lukeMiP/Beat-Box/v4/MEDIA/Untitled Project (7).jpg

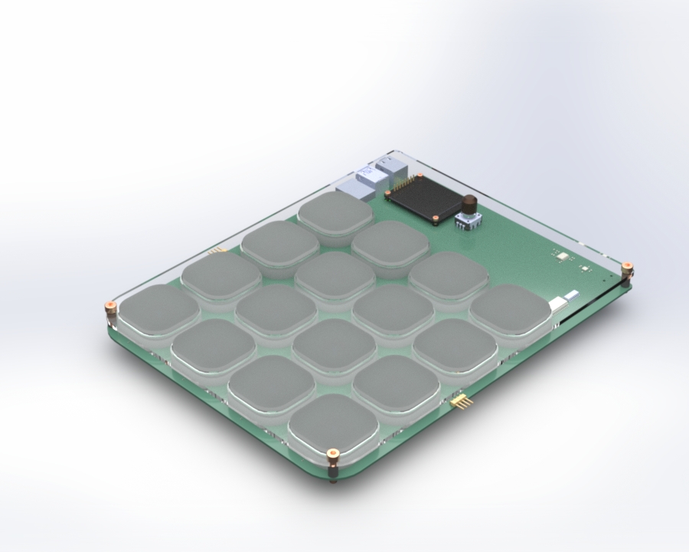
v4/MEDIA/Untitled Project (7).jpg
