lukeMiP/Beat-Box/v4/MEDIA/layout image.png

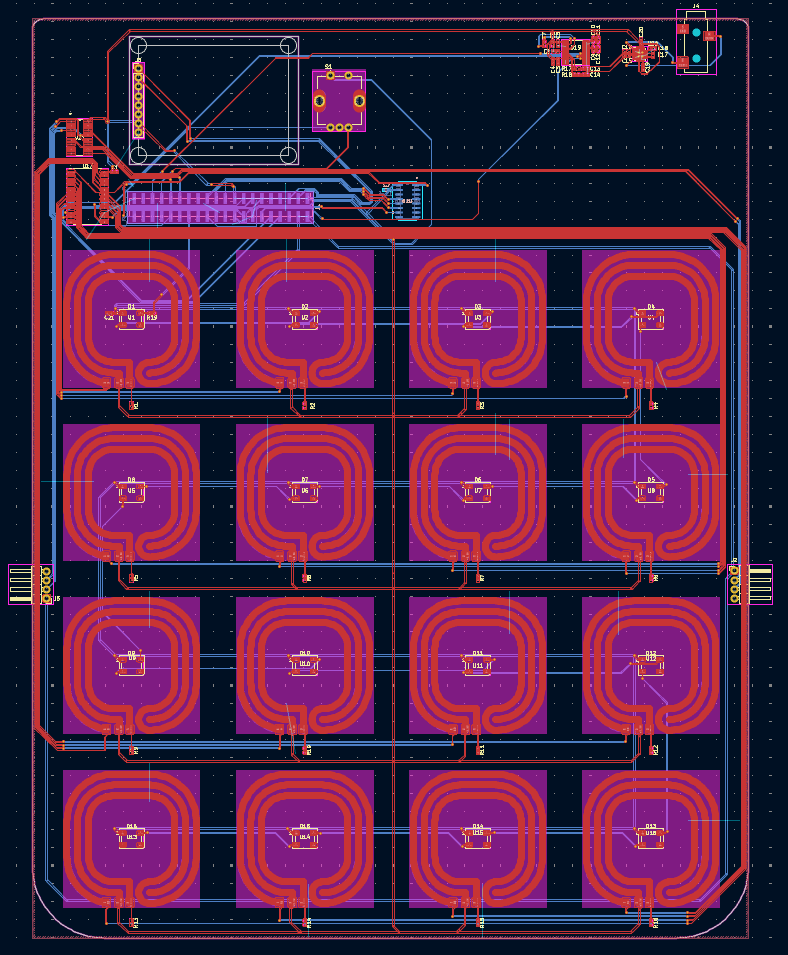
v4/MEDIA/layout image.png
