lukeMiP/Beat-Box/v3/SOLIDWORKS/V3.SLDASM

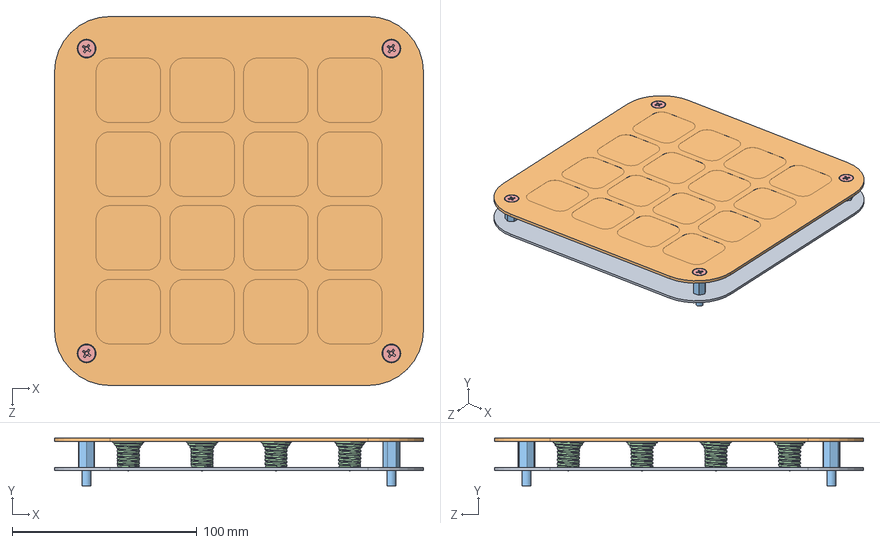
[picture p3: CAD file, 2025-08-02, an earlier design]
v3/SOLIDWORKS/V3.SLDASM
200.0 x 26.0 x 200.0 mm
PCB
Top
Standoffs x 4
CapacitiveTouchSpring x 16
cross countersunk head screw_as x 4
