lukeMiP/Beat-Box/v1/SOLIDWORKS/Full Assem v1.SLDASM

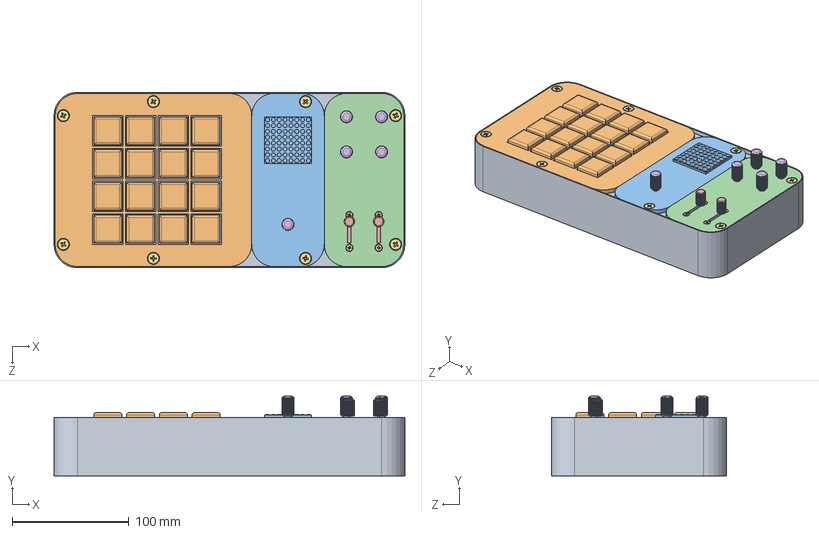
[picture p4: CAD file, 2025-08-02, an earlier design]
v1/SOLIDWORKS/Full Assem v1.SLDASM
300.0 x 68.0 x 150.0 mm
Base
KeyPad
Visulize
Switch Plate
Slide x 2
Knob x 5
cross countersunk head screw_as x 12
