lukeMiP/Beat-Box/v2/SOLIDWORKS/Full Assem v2.SLDASM

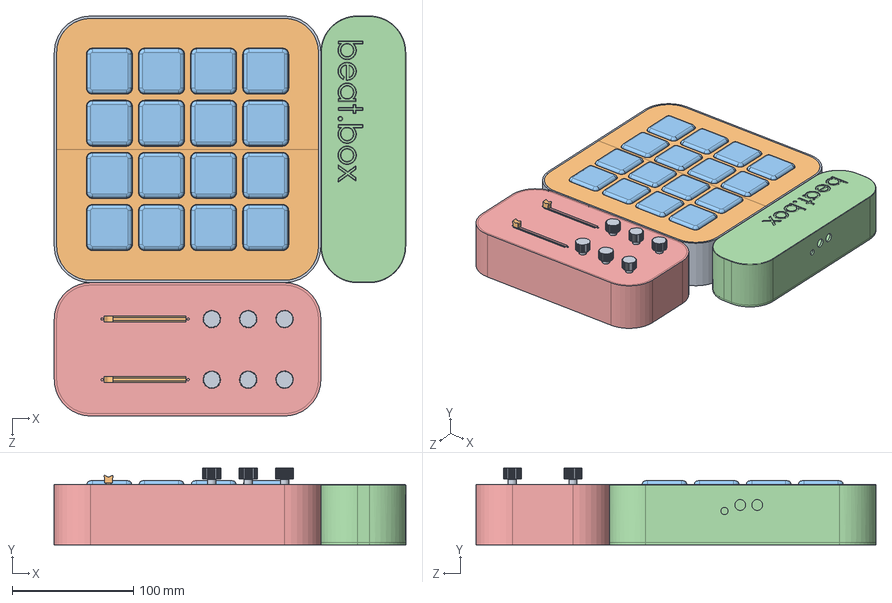
[picture p5: CAD file, 2025-08-02, an earlier design]
v2/SOLIDWORKS/Full Assem v2.SLDASM
290.0 x 63.5 x 330.0 mm
Drum Top Plate
SoundPlayer
PotPad
cross countersunk head screw_as x 4
MagPlug x 2
MagSocket x 2
Pot x 6
SlidePot x 2
