lukeMiP/Beat-Box/v1/SOLIDWORKS/Base.SLDPRT

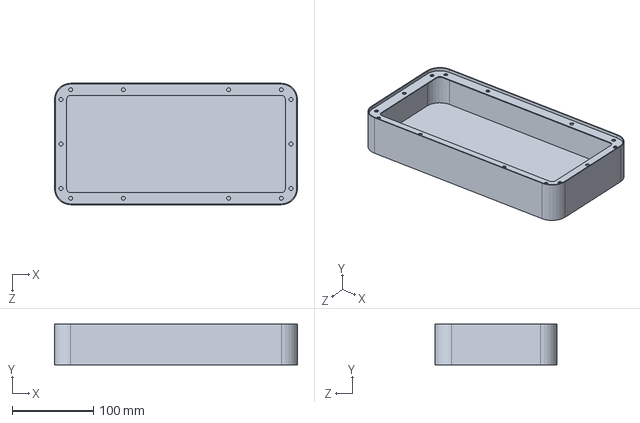
[picture p6: CAD file, 2025-08-02, an earlier design]
v1/SOLIDWORKS/Base.SLDPRT
300.0 x 50.0 x 150.0 mm
