lukeMiP/Beat-Box/v2/SOLIDWORKS/MagPlug.SLDPRT

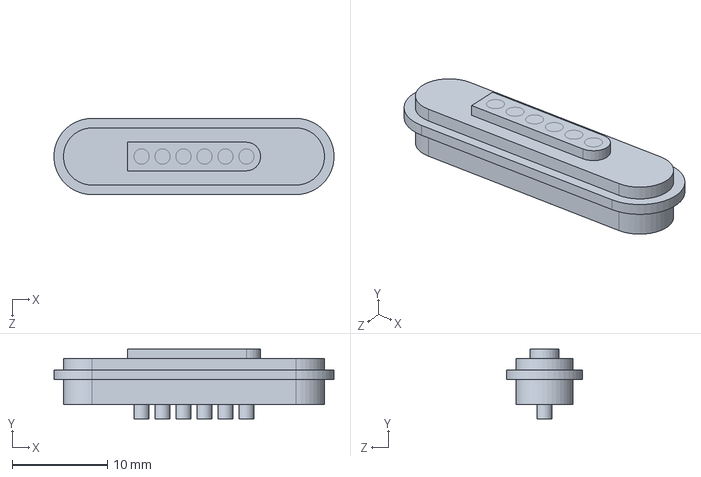
[picture p7: CAD file, 2025-08-02, an earlier design]
v2/SOLIDWORKS/MagPlug.SLDPRT
29.4 x 7.30 x 8.00 mm
