lukeMiP/Beat-Box/v3/SOLIDWORKS/Standoffs.SLDPRT

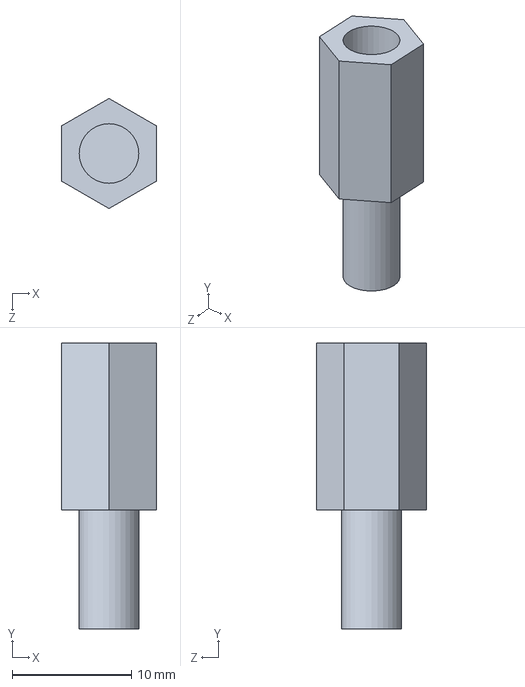
[picture p8: CAD file, 2025-08-02, an earlier design]
v3/SOLIDWORKS/Standoffs.SLDPRT
8.00 x 24.0 x 9.24 mm
