lukeMiP/Beat-Box/v1/SOLIDWORKS/KeyPad.SLDPRT

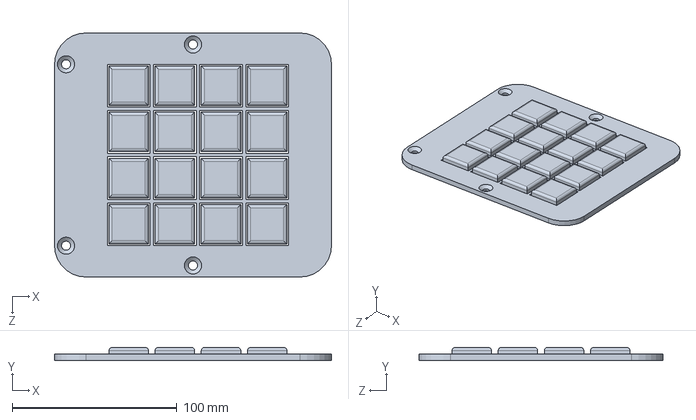
[picture p9: CAD file, 2025-08-02, an earlier design]
v1/SOLIDWORKS/KeyPad.SLDPRT
168.0 x 8.00 x 148.0 mm
