lukeMiP/Beat-Box/v2/SOLIDWORKS/TopOpen.SLDPRT

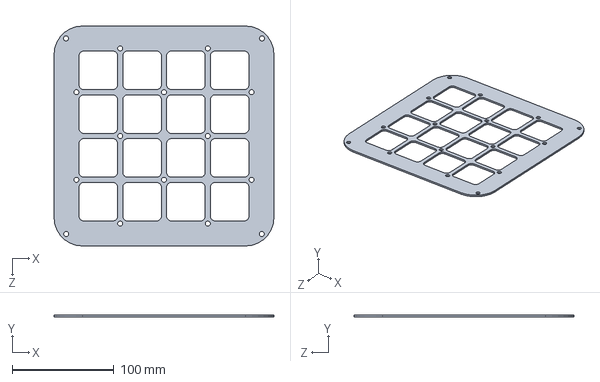
[picture p10: CAD file, 2025-08-02, an earlier design]
v2/SOLIDWORKS/TopOpen.SLDPRT
216.0 x 2.00 x 216.0 mm
