lukeMiP/Beat-Box/v3/SOLIDWORKS/CapacitiveTouchSpring.SLDPRT

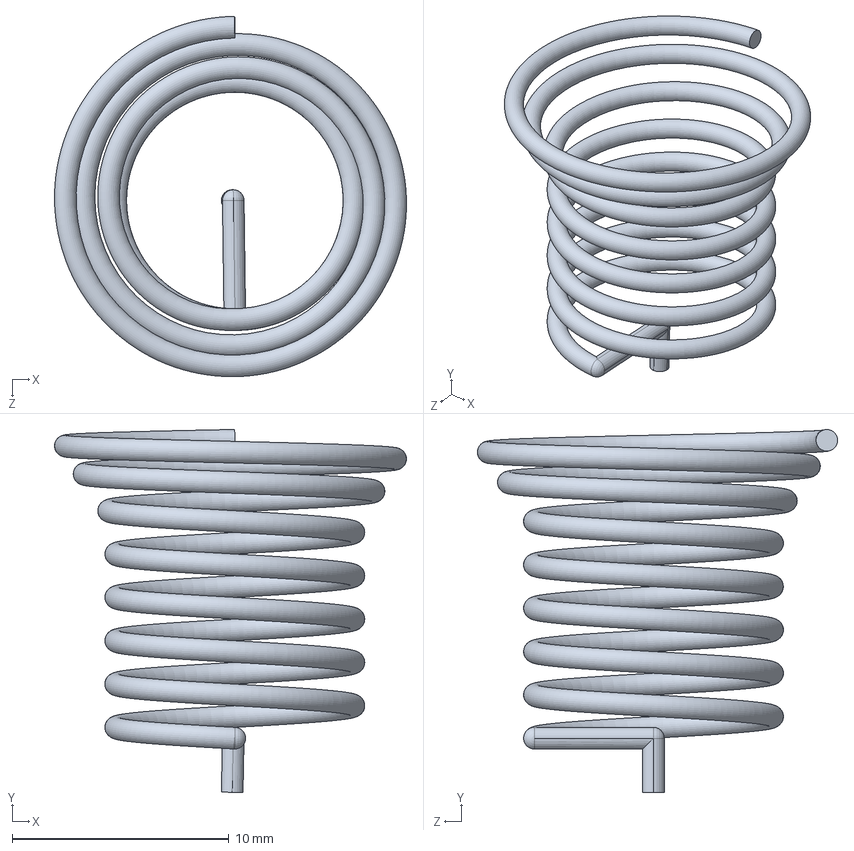
[picture p11: CAD file, 2025-08-02, an earlier design]
v3/SOLIDWORKS/CapacitiveTouchSpring.SLDPRT
16.2 x 16.8 x 16.6 mm
