lukeMiP/Beat-Box/v1/SOLIDWORKS/Switch Plate.SLDPRT

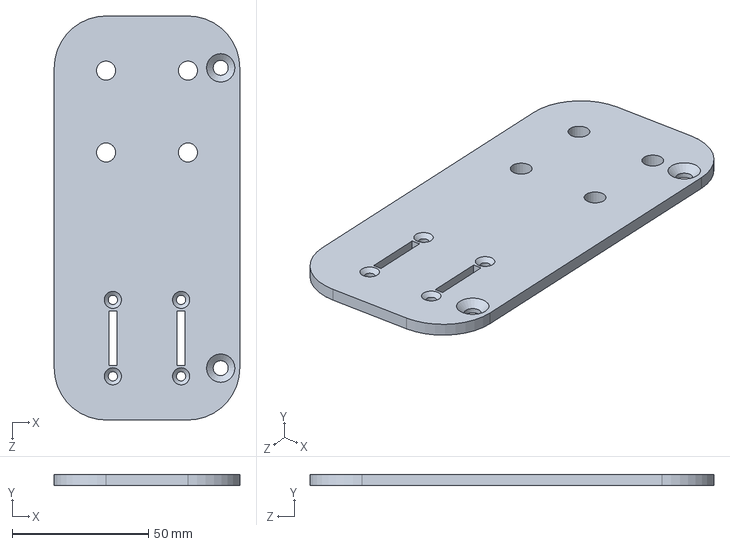
[picture p12: CAD file, 2025-08-02, an earlier design]
v1/SOLIDWORKS/Switch Plate.SLDPRT
68.0 x 4.00 x 148.0 mm
