lukeMiP/Beat-Box/v2/SOLIDWORKS/Drum Top Plate.SLDPRT

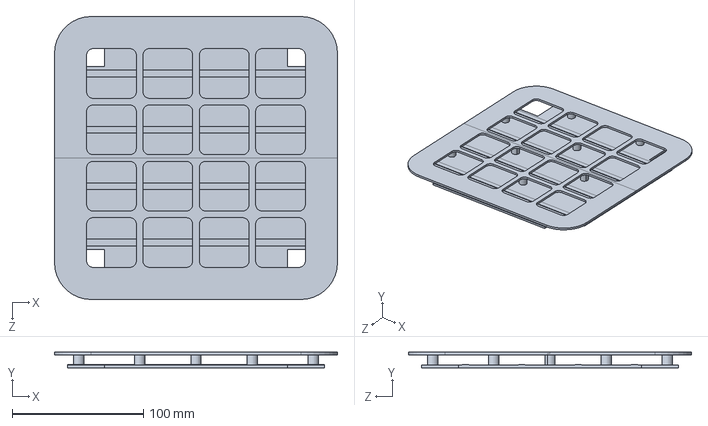
[picture p13: CAD file, 2025-08-02, an earlier design]
v2/SOLIDWORKS/Drum Top Plate.SLDPRT
216.0 x 12.0 x 216.0 mm
