lukeMiP/Beat-Box/v2/SOLIDWORKS/Drum Base.SLDPRT

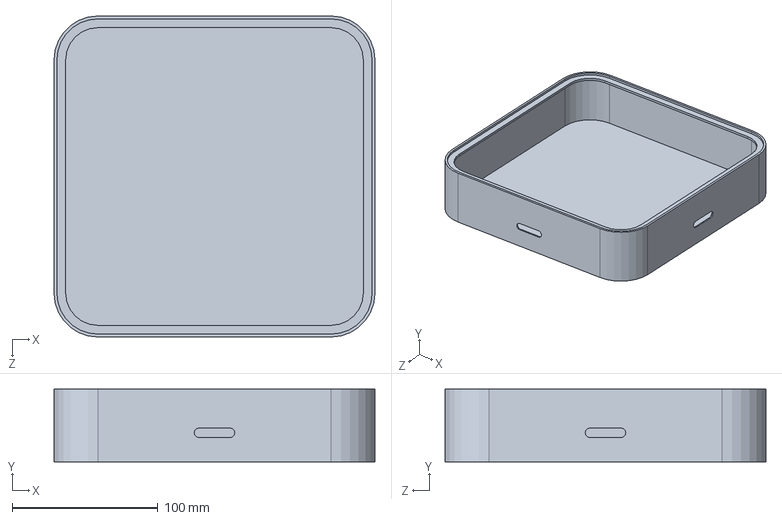
[picture p14: CAD file, 2025-08-02, an earlier design]
v2/SOLIDWORKS/Drum Base.SLDPRT
220.0 x 50.0 x 220.0 mm
