lukeMiP/Beat-Box/v3/SOLIDWORKS/Top.SLDPRT

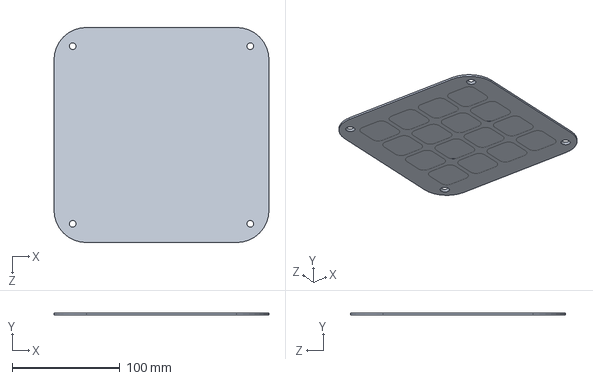
[picture p15: CAD file, 2025-08-02, an earlier design]
v3/SOLIDWORKS/Top.SLDPRT
200.0 x 2.00 x 200.0 mm
