lukeMiP/Beat-Box/v1/SOLIDWORKS/Knob.SLDPRT

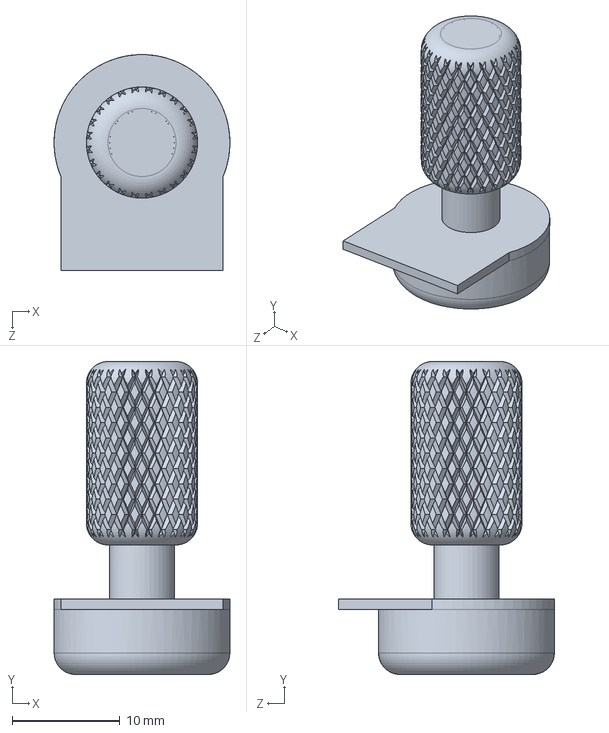
[picture p16: CAD file, 2025-08-02, an earlier design]
v1/SOLIDWORKS/Knob.SLDPRT
16.3 x 29.0 x 20.0 mm
