lukeMiP/Beat-Box/v2/SOLIDWORKS/Button.SLDPRT

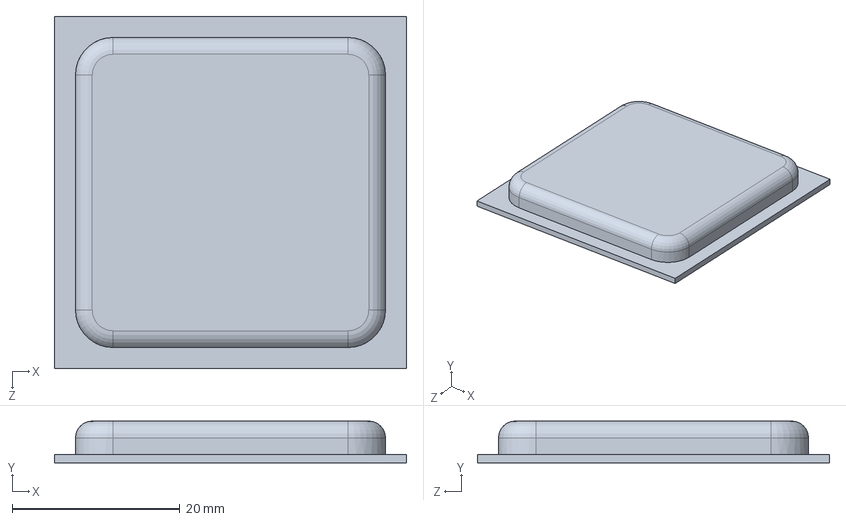
[picture p17: CAD file, 2025-08-02, an earlier design]
v2/SOLIDWORKS/Button.SLDPRT
42.0 x 5.00 x 42.0 mm
