lukeMiP/Beat-Box/v3/SOLIDWORKS/PCB.SLDPRT

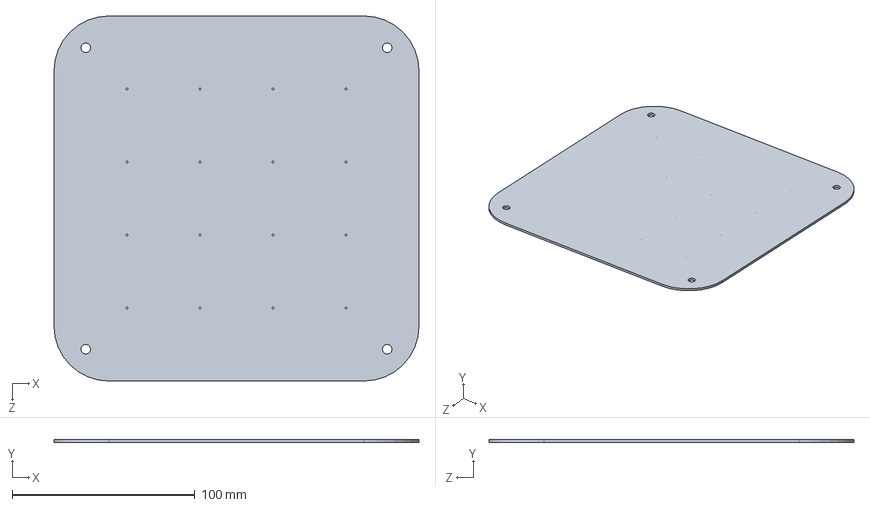
[picture p18: CAD file, 2025-08-02, an earlier design]
v3/SOLIDWORKS/PCB.SLDPRT
200.0 x 1.60 x 200.0 mm
