lukeMiP/Beat-Box/v1/SOLIDWORKS/Visulize.SLDPRT

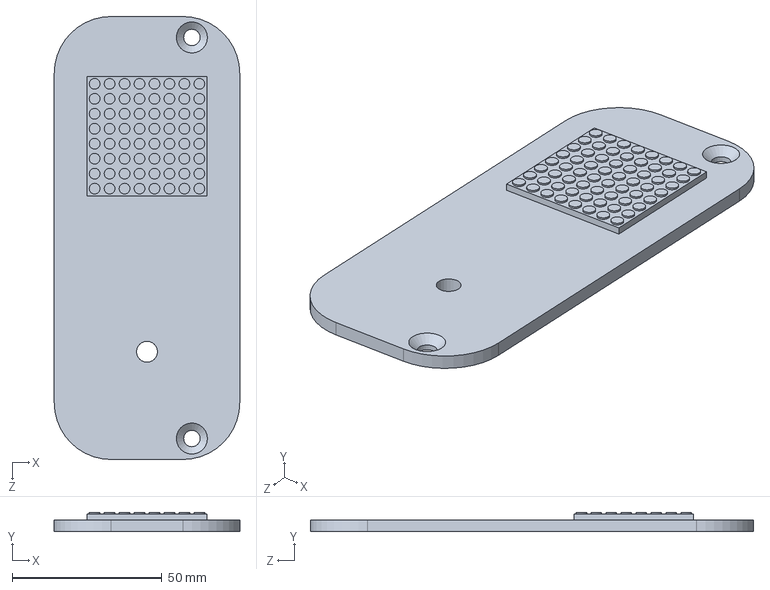
[picture p19: CAD file, 2025-08-02, an earlier design]
v1/SOLIDWORKS/Visulize.SLDPRT
62.0 x 6.50 x 148.0 mm
