lukeMiP/Beat-Box/v2/SOLIDWORKS/StandoffOpen.SLDPRT

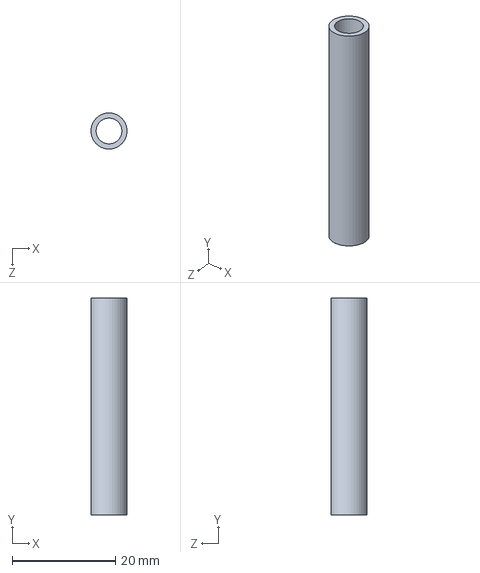
[picture p20: CAD file, 2025-08-02, an earlier design]
v2/SOLIDWORKS/StandoffOpen.SLDPRT
6.98 x 42.0 x 7.00 mm
