lukeMiP/Beat-Box/(list of files, cad)

Other CAD files:
v1/SOLIDWORKS/Slide.SLDPRT
v2/SOLIDWORKS/BottomOpen.SLDPRT
v2/SOLIDWORKS/MagHolderOpen.SLDPRT
v2/SOLIDWORKS/MagSocket.SLDPRT
v2/SOLIDWORKS/Pad.SLDPRT
v2/SOLIDWORKS/Pot.SLDPRT
v2/SOLIDWORKS/PotPad.SLDPRT
v2/SOLIDWORKS/SlidePot.SLDPRT
v2/SOLIDWORKS/SoundPlayer.SLDPRT
