lukeMiP/Beat-Box/v2/EASYEDA/Schematic_DrumV2_2025-08-02.pdf

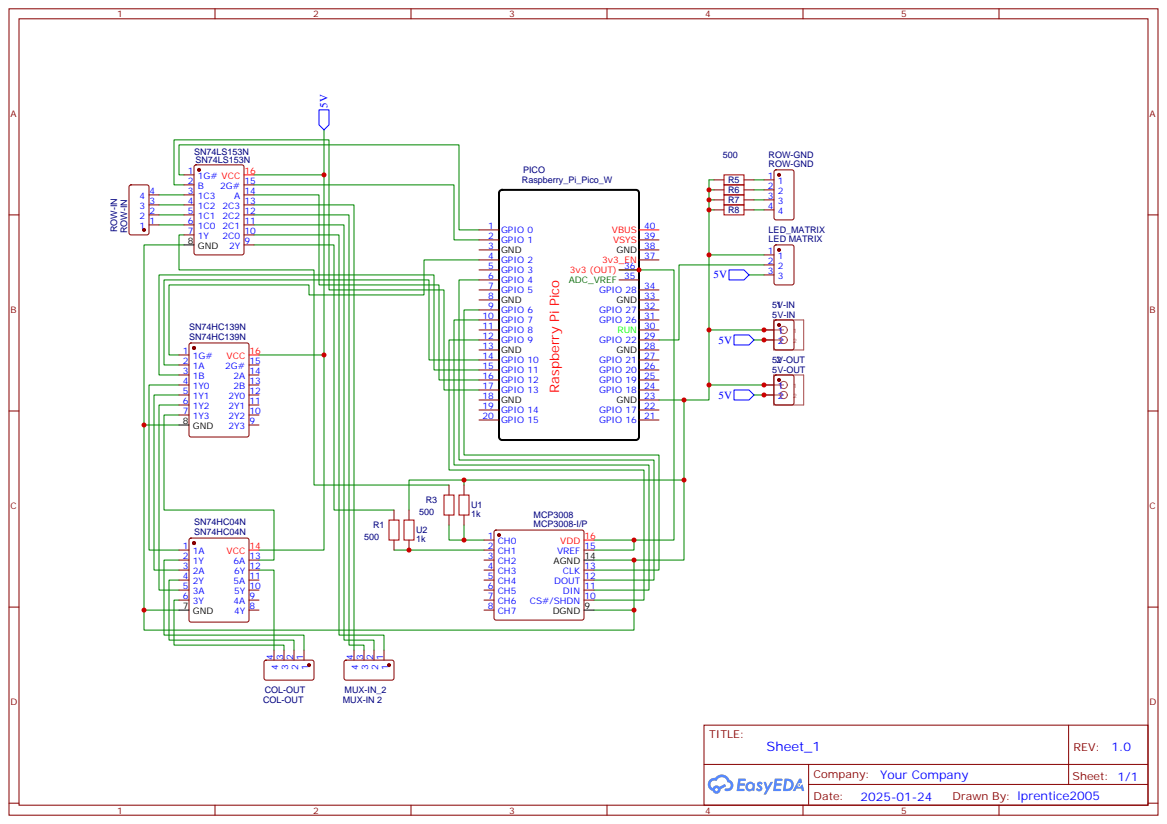
[picture p21: page 1]

MCP3008
MCP3008-I/P
CS#/SHDN 10 DIN 11 DOUT 12 CLK 13 AGND 14 VREF 15 VDD 16
