lukeMiP/Beat-Box/v2/EASYEDA/PCB_PCB_DrumV2_2025-08-02.pdf

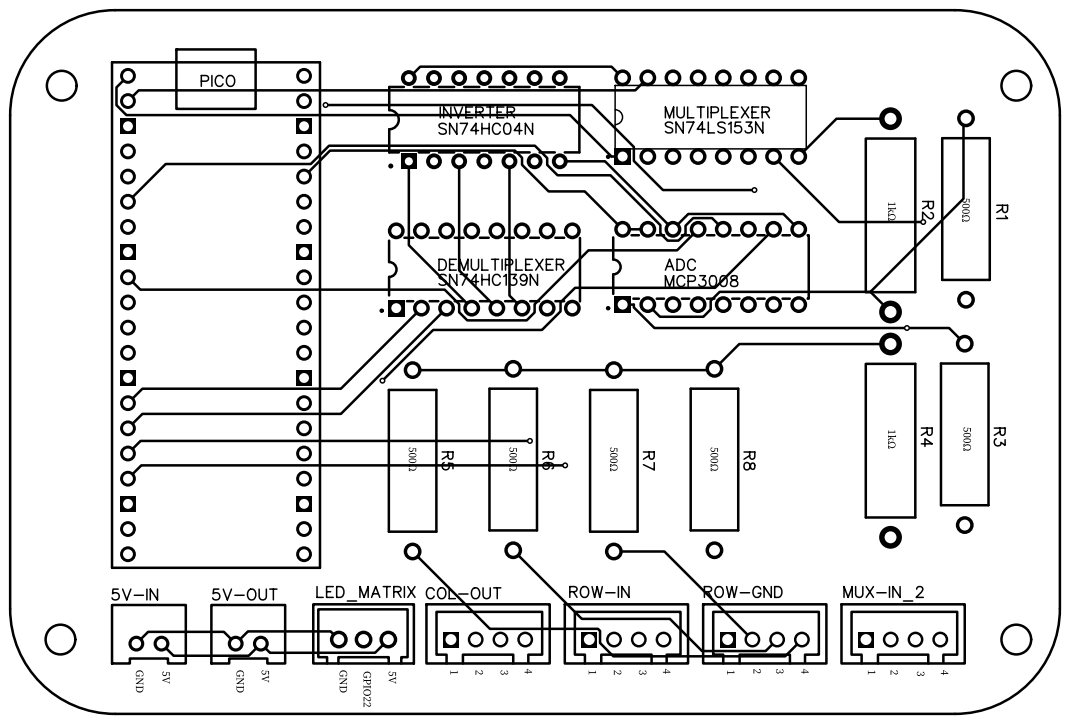
[picture p22: page 1]
