lukeMiP/Beat-Box/v2/SOLIDWORKS/DrumV2.pdf

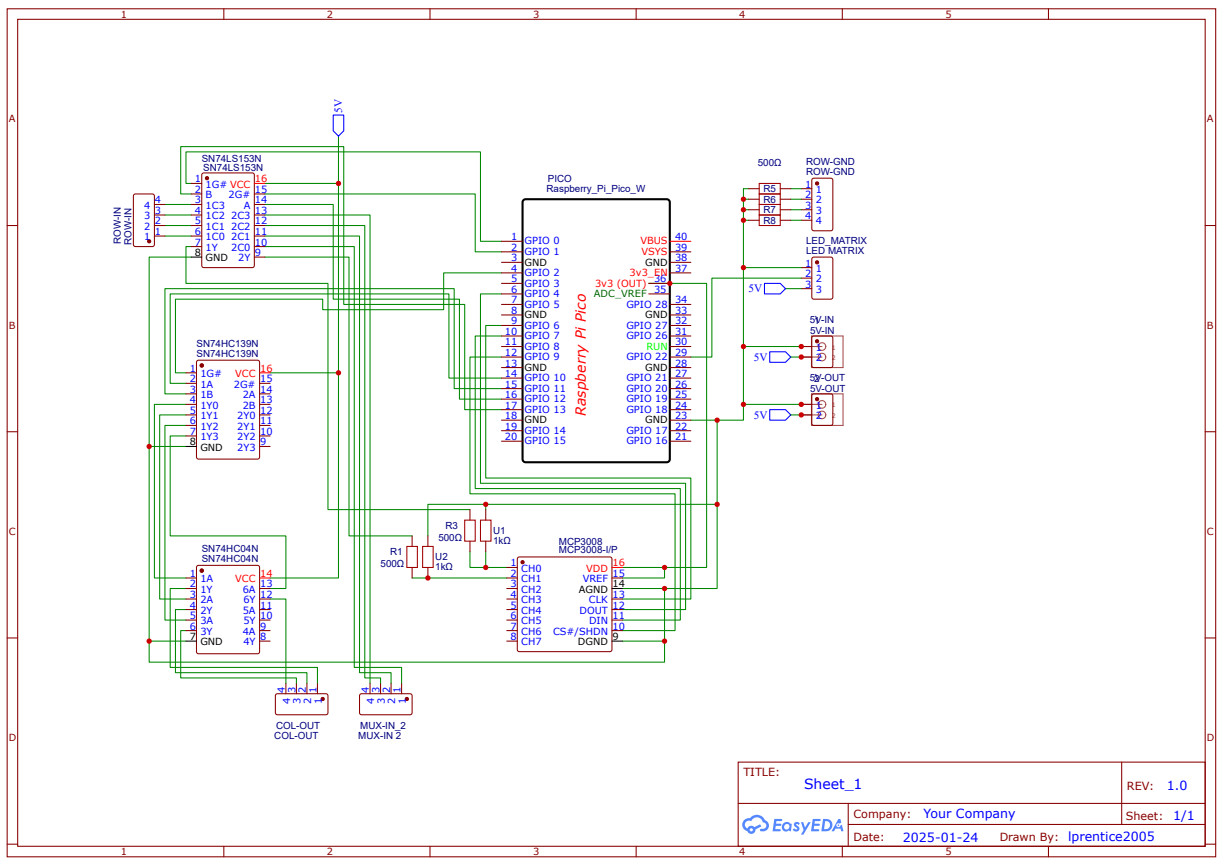
[picture p23: page 1]
