lukeMiP/Beat-Box/v4/FINAL VERSION/KiCad/final version.kicad_pcb

## KiCad design v4/FINAL VERSION/KiCad/final version.kicad_pcb (2025-08-17)

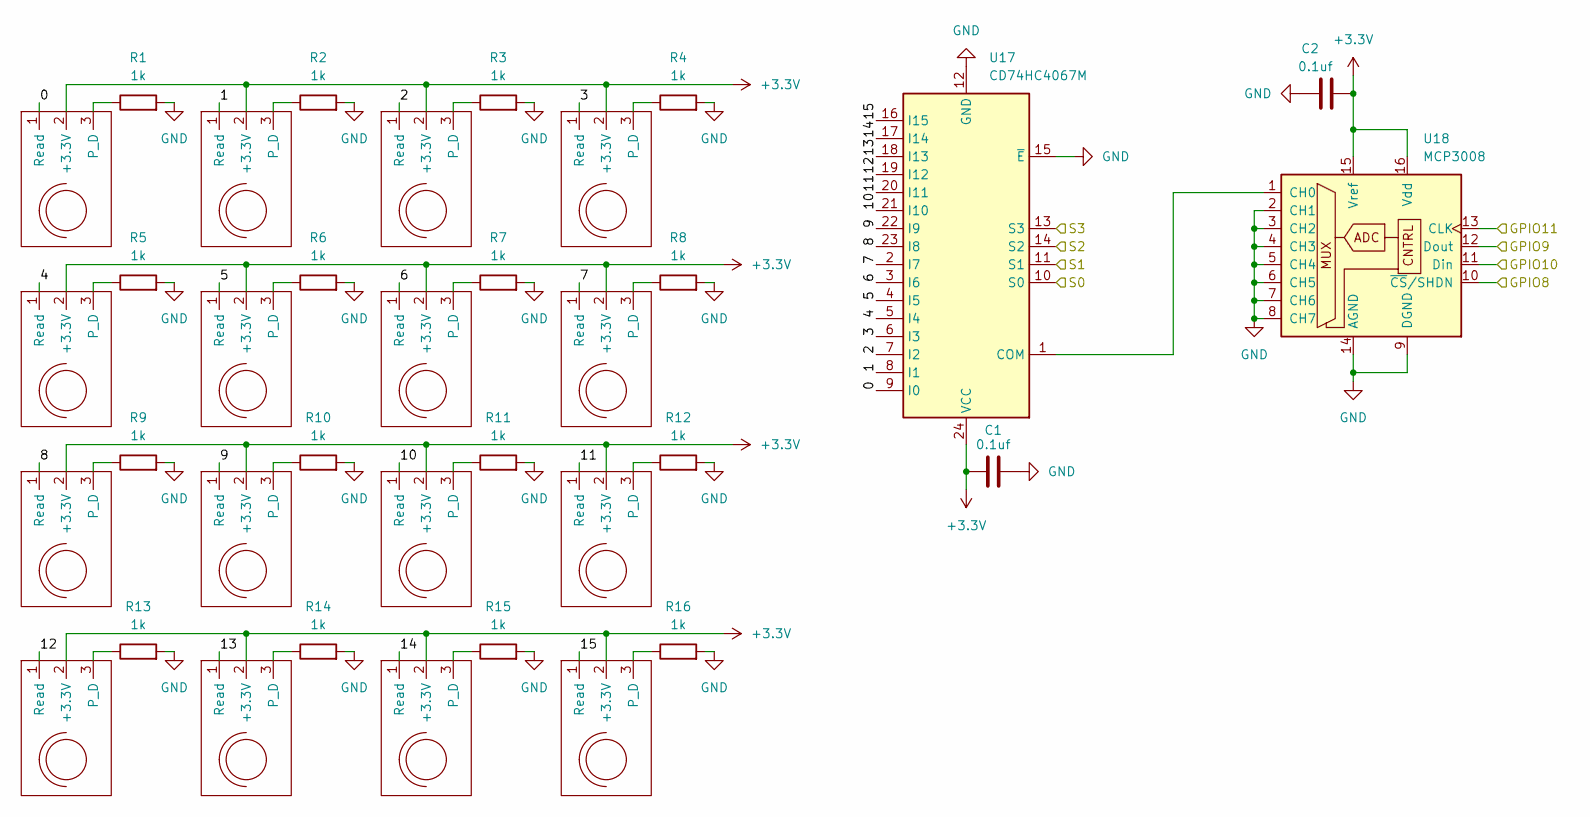
[picture p24: schematic MATRIX.kicad_sch]

Parts:
C1, C2: 0.1uf; C_0805_2012Metric_Pad1.18x1.45mm_HandSolder
R1, R2, R3, R4, R5, R6, R7, R8, R9, R10, R11, R12, R13, R14, R15, R16: 1k; R_0805_2012Metric_Pad1.20x1.40mm_HandSolder
U1, U2, U3, U4, U5, U6, U7, U8, U9, U10, U11, U12, U13, U14, U15, U16: VeloPad
U17: CD74HC4067M; SOIC-24W_7.5x15.4mm_P1.27mm
U18: MCP3008; SOIC16-N_MC_MCH-M

Connections:
+3.3V: C1.1, C2.1, U1.2 (+3.3V), U2.2 (+3.3V), U3.2 (+3.3V), U4.2 (+3.3V), U5.2 (+3.3V), U6.2 (+3.3V), U7.2 (+3.3V), U8.2 (+3.3V), U9.2 (+3.3V), U10.2 (+3.3V), U11.2 (+3.3V), U12.2 (+3.3V), U13.2 (+3.3V), U14.2 (+3.3V), U15.2 (+3.3V), U16.2 (+3.3V), U17.24 (VCC), U18.15 (Vref), U18.16 (Vdd); also elsewhere on the board
/MATRIX/0: U1.1 (Read), U17.9 (I0)
/MATRIX/1: U2.1 (Read), U17.8 (I1)
/MATRIX/2: U3.1 (Read), U17.7 (I2)
/MATRIX/3: U4.1 (Read), U17.6 (I3)
/MATRIX/4: U5.1 (Read), U17.5 (I4)
/MATRIX/5: U6.1 (Read), U17.4 (I5)
/MATRIX/6: U7.1 (Read), U17.3 (I6)
/MATRIX/7: U8.1 (Read), U17.2 (I7)
/MATRIX/8: U9.1 (Read), U17.23 (I8)
/MATRIX/9: U10.1 (Read), U17.22 (I9)
/MATRIX/10: U11.1 (Read), U17.21 (I10)
/MATRIX/11: U12.1 (Read), U17.20 (I11)
/MATRIX/12: U13.1 (Read), U17.19 (I12)
/MATRIX/13: U14.1 (Read), U17.18 (I13)
/MATRIX/14: U15.1 (Read), U17.17 (I14)
/MATRIX/15: U16.1 (Read), U17.16 (I15)
/MATRIX/GPIO8: U18.10 (~CS/SHDN); also elsewhere on the board
/MATRIX/GPIO9: U18.12 (Dout); also elsewhere on the board
/MATRIX/GPIO10: U18.11 (Din); also elsewhere on the board
/MATRIX/GPIO11: U18.13 (CLK); also elsewhere on the board
/MATRIX/S0: U17.10 (S0); also elsewhere on the board
/MATRIX/S1: U17.11 (S1); also elsewhere on the board
/MATRIX/S2: U17.14 (S2); also elsewhere on the board
/MATRIX/S3: U17.13 (S3); also elsewhere on the board
GND: C1.2, C2.2, R1.2, R2.2, R3.2, R4.2, R5.2, R6.2, R7.2, R8.2, R9.2, R10.2, R11.2, R12.2, R13.2, R14.2, R15.2, R16.2, U17.12 (GND), U17.15 (~E), U18.2 (CH1), U18.3 (CH2), U18.4 (CH3), U18.5 (CH4), U18.6 (CH5), U18.7 (CH6), U18.8 (CH7), U18.9 (DGND), U18.14 (AGND); also elsewhere on the board
unnamed: R1.1, U1.3 (P_D)
unnamed: R2.1, U2.3 (P_D)
unnamed: R3.1, U3.3 (P_D)
unnamed: R4.1, U4.3 (P_D)
unnamed: R5.1, U5.3 (P_D)
unnamed: R6.1, U6.3 (P_D)
unnamed: R7.1, U7.3 (P_D)
unnamed: R8.1, U8.3 (P_D)
unnamed: R9.1, U9.3 (P_D)
unnamed: R10.1, U10.3 (P_D)
unnamed: R11.1, U11.3 (P_D)
unnamed: R12.1, U12.3 (P_D)
unnamed: R13.1, U13.3 (P_D)
unnamed: R14.1, U14.3 (P_D)
unnamed: R15.1, U15.3 (P_D)
unnamed: R16.1, U16.3 (P_D)
unnamed: U17.1 (COM), U18.1 (CH0)

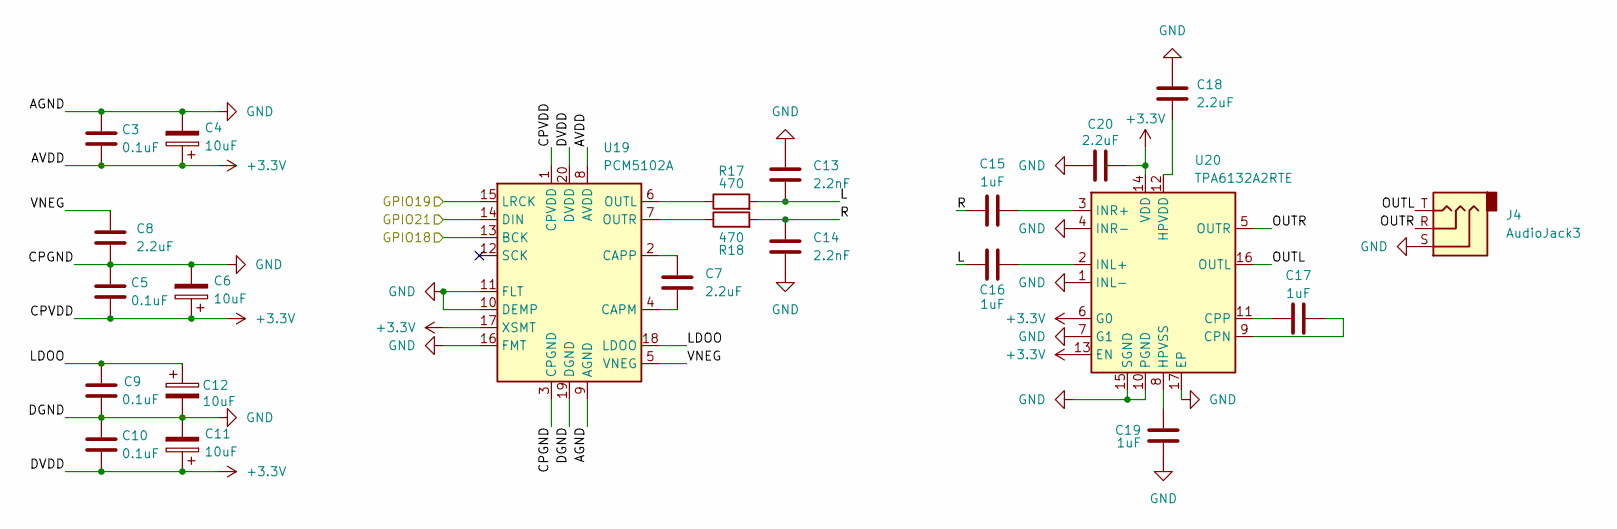
[picture p25: schematic DAC.kicad_sch]

Parts:
C3, C5, C9, C10: 0.1uF; C_0805_2012Metric_Pad1.18x1.45mm_HandSolder
C4, C6, C11, C12: 10uF; C_0805_2012Metric_Pad1.18x1.45mm_HandSolder
C7, C8, C18, C20: 2.2uF; C_0805_2012Metric_Pad1.18x1.45mm_HandSolder
C13, C14: 2.2nF; C_0805_2012Metric_Pad1.18x1.45mm_HandSolder
C15, C16, C17, C19: 1uF; C_0805_2012Metric_Pad1.18x1.45mm_HandSolder
J4: AudioJack3; Jack_3.5mm_CUI_SJ-3523-SMT_Horizontal
R17, R18: 470; R_0805_2012Metric_Pad1.20x1.40mm_HandSolder
U19: PCM5102A; TSSOP-20_4.4x6.5mm_P0.65mm
U20: TPA6132A2RTE; WQFN-16-1EP_3x3mm_P0.5mm_EP1.6x1.6mm_ThermalVias

Connections:
+3.3V: C3.2, C4.1, C5.2, C6.1, C10.2, C11.1, C20.2, U19.1 (CPVDD), U19.8 (AVDD), U19.17 (XSMT), U19.20 (DVDD), U20.6 (G0), U20.13 (EN), U20.14 (VDD); also elsewhere on the board
/DAC/GPIO18: U19.13 (BCK); also elsewhere on the board
/DAC/GPIO19: U19.15 (LRCK); also elsewhere on the board
/DAC/GPIO21: U19.14 (DIN); also elsewhere on the board
/DAC/L: C13.2, C16.2, R17.2
/DAC/LDOO: C9.1, C12.1, U19.18 (LDOO)
/DAC/OUTL: J4.T, U20.16 (OUTL)
/DAC/OUTR: J4.R, U20.5 (OUTR)
/DAC/R: C14.1, C15.1, R18.2
/DAC/VNEG: C8.1, U19.5 (VNEG)
GND: C3.1, C4.2, C5.1, C6.2, C8.2, C9.2, C10.1, C11.2, C12.2, C13.1, C14.2, C18.1, C19.1, C20.1, J4.S, U19.3 (CPGND), U19.9 (AGND), U19.10 (DEMP), U19.11 (FLT), U19.16 (FMT), U19.19 (DGND), U20.1 (INL-), U20.4 (INR-), U20.7 (G1), U20.10 (PGND), U20.15 (SGND), U20.17 (EP); also elsewhere on the board
unnamed: C7.2, U19.4 (CAPM)
unnamed: C7.1, U19.2 (CAPP)
unnamed: R17.1, U19.6 (OUTL)
unnamed: R18.1, U19.7 (OUTR)
unnamed: C17.1, U20.9 (CPN)
unnamed: C17.2, U20.11 (CPP)
unnamed: C18.2, U20.12 (HPVDD)
unnamed: C19.2, U20.8 (HPVSS)
unnamed: C16.1, U20.2 (INL+)
unnamed: C15.2, U20.3 (INR+)

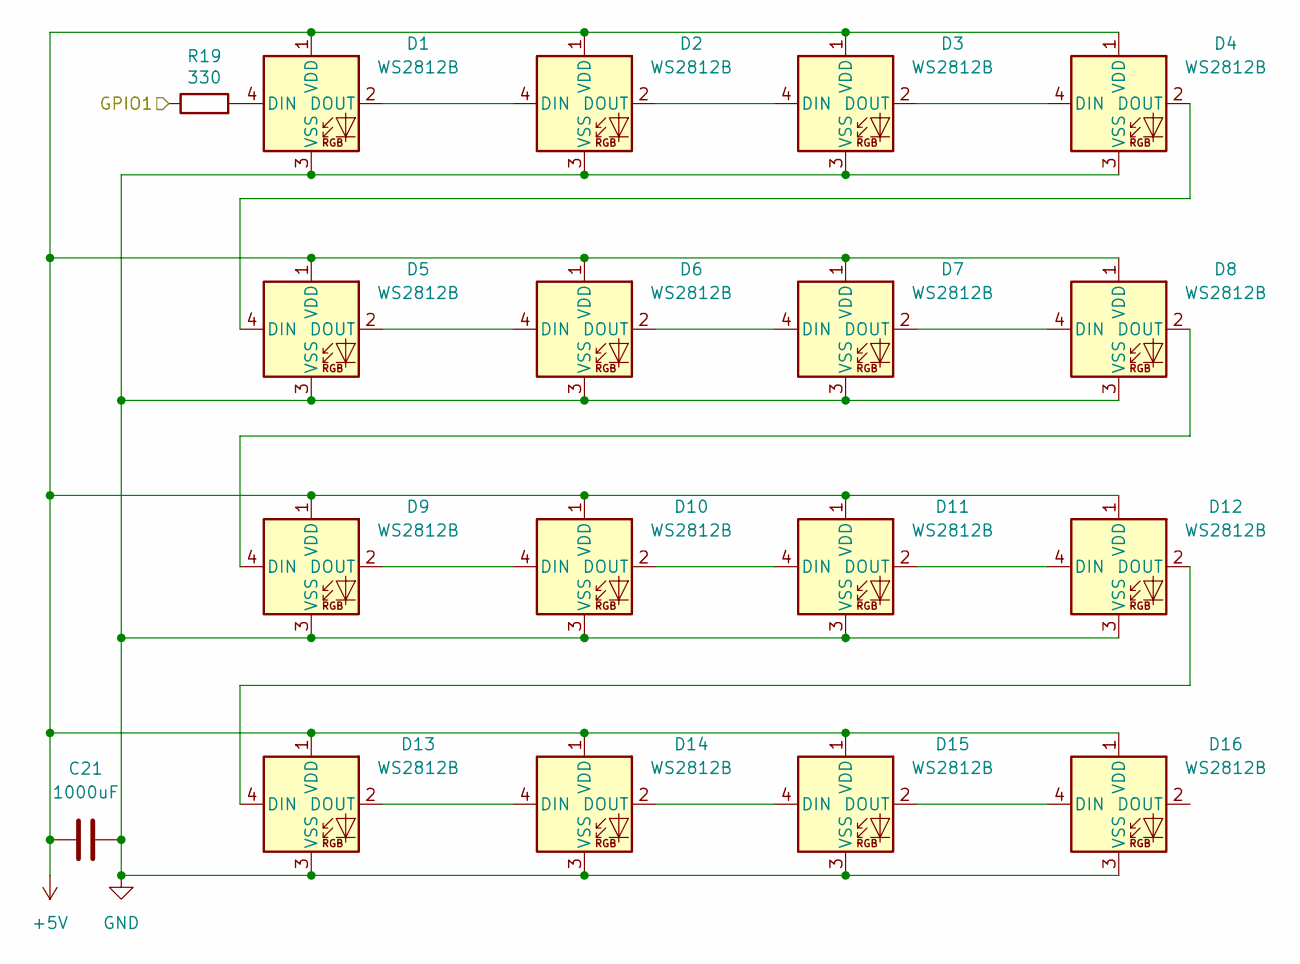
[picture p26: schematic LED_Matrix.kicad_sch]

Parts:
C21: 1000uF; C_0805_2012Metric_Pad1.18x1.45mm_HandSolder
D1, D2, D3, D4, D5, D6, D7, D8, D9, D10, D11, D12, D13, D14, D15, D16: WS2812B; LED_WS2812B_PLCC4_5.0x5.0mm_P3.2mm
R19: 330; R_0805_2012Metric_Pad1.20x1.40mm_HandSolder

Connections:
+5V: C21.1, D1.1 (VDD), D2.1 (VDD), D3.1 (VDD), D4.1 (VDD), D5.1 (VDD), D6.1 (VDD), D7.1 (VDD), D8.1 (VDD), D9.1 (VDD), D10.1 (VDD), D11.1 (VDD), D12.1 (VDD), D13.1 (VDD), D14.1 (VDD), D15.1 (VDD), D16.1 (VDD); also elsewhere on the board
/LED_Matrix/GPIO1: R19.1; also elsewhere on the board
GND: C21.2, D1.3 (VSS), D2.3 (VSS), D3.3 (VSS), D4.3 (VSS), D5.3 (VSS), D6.3 (VSS), D7.3 (VSS), D8.3 (VSS), D9.3 (VSS), D10.3 (VSS), D11.3 (VSS), D12.3 (VSS), D13.3 (VSS), D14.3 (VSS), D15.3 (VSS), D16.3 (VSS); also elsewhere on the board
unnamed: D1.4 (DIN), R19.2
unnamed: D1.2 (DOUT), D2.4 (DIN)
unnamed: D2.2 (DOUT), D3.4 (DIN)
unnamed: D3.2 (DOUT), D4.4 (DIN)
unnamed: D4.2 (DOUT), D5.4 (DIN)
unnamed: D5.2 (DOUT), D6.4 (DIN)
unnamed: D6.2 (DOUT), D7.4 (DIN)
unnamed: D7.2 (DOUT), D8.4 (DIN)
unnamed: D8.2 (DOUT), D9.4 (DIN)
unnamed: D9.2 (DOUT), D10.4 (DIN)
unnamed: D10.2 (DOUT), D11.4 (DIN)
unnamed: D11.2 (DOUT), D12.4 (DIN)
unnamed: D12.2 (DOUT), D13.4 (DIN)
unnamed: D13.2 (DOUT), D14.4 (DIN)
unnamed: D14.2 (DOUT), D15.4 (DIN)
unnamed: D15.2 (DOUT), D16.4 (DIN)

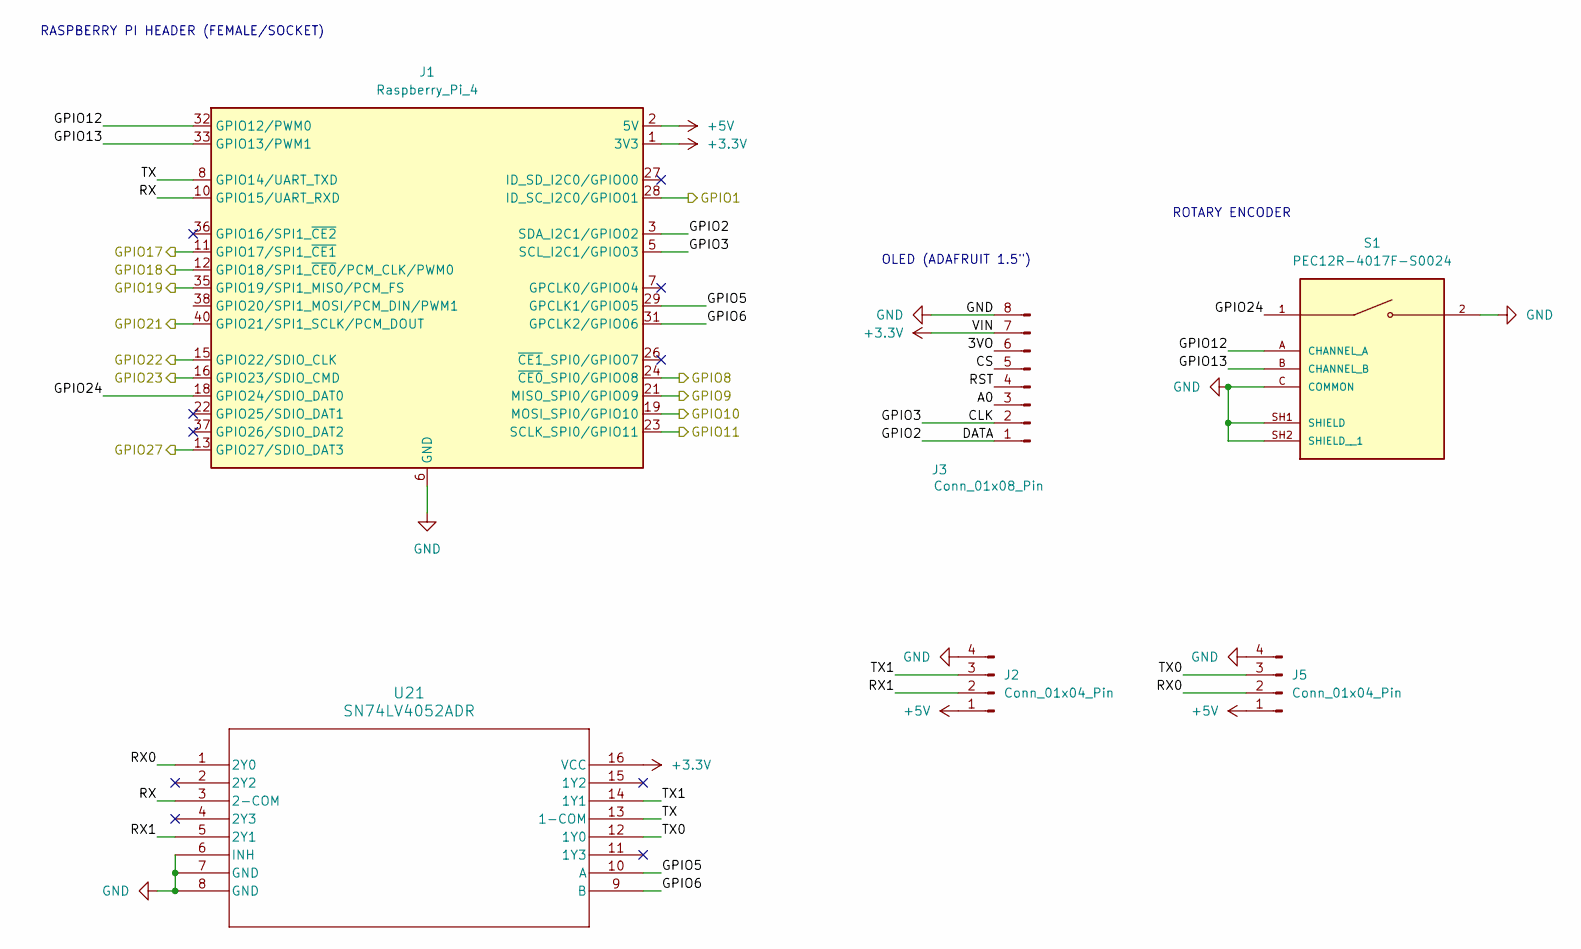
[picture p27: schematic CM5.kicad_sch]

Parts:
J1: Raspberry_Pi_4; PinSocket_2x20_P2.54mm_Vertical_SMD
J2, J5: Conn_01x04_Pin; PinHeader_1x04_P2.54mm_Horizontal
J3: Conn_01x08_Pin; PinHeader_1x08_P2.54mm_Vertical
S1: PEC12R-4017F-S0024; XDCR_PEC12R-4017F-S0024; PARTREV 07/21
U21: SN74LV4052ADR; D16

Connections:
+3.3V: J1.1 (3V3), J1.17 (3V3), J3.7, U21.16 (VCC); also elsewhere on the board
+5V: J1.2 (5V), J1.4 (5V), J2.1, J5.1; also elsewhere on the board
/DAC/GPIO18: J1.12 (GPIO18/SPI1_~CE0/PCM_CLK/PWM0); also elsewhere on the board
/DAC/GPIO19: J1.35 (GPIO19/SPI1_MISO/PCM_FS); also elsewhere on the board
/DAC/GPIO21: J1.40 (GPIO21/SPI1_SCLK/PCM_DOUT); also elsewhere on the board
/LED_Matrix/GPIO1: J1.28 (ID_SC_I2C0/GPIO01); also elsewhere on the board
/MATRIX/GPIO8: J1.24 (~CE0_SPI0/GPIO08); also elsewhere on the board
/MATRIX/GPIO9: J1.21 (MISO_SPI0/GPIO09); also elsewhere on the board
/MATRIX/GPIO10: J1.19 (MOSI_SPI0/GPIO10); also elsewhere on the board
/MATRIX/GPIO11: J1.23 (SCLK_SPI0/GPIO11); also elsewhere on the board
/MATRIX/S0: J1.11 (GPIO17/SPI1_~CE1); also elsewhere on the board
/MATRIX/S1: J1.13 (GPIO27/SDIO_DAT3); also elsewhere on the board
/MATRIX/S2: J1.16 (GPIO23/SDIO_CMD); also elsewhere on the board
/MATRIX/S3: J1.15 (GPIO22/SDIO_CLK); also elsewhere on the board
/Rasp Pi/3VO: J3.6
/Rasp Pi/A0: J3.3
/Rasp Pi/CLK: J1.5 (SCL_I2C1/GPIO03), J3.2
/Rasp Pi/CS: J3.5
/Rasp Pi/DATA: J1.3 (SDA_I2C1/GPIO02), J3.1
/Rasp Pi/GPIO5: J1.29 (GPCLK1/GPIO05), U21.10 (A)
/Rasp Pi/GPIO6: J1.31 (GPCLK2/GPIO06), U21.9 (B)
/Rasp Pi/GPIO12: J1.32 (GPIO12/PWM0), S1.A (CHANNEL_A)
/Rasp Pi/GPIO13: J1.33 (GPIO13/PWM1), S1.B (CHANNEL_B)
/Rasp Pi/GPIO24: J1.18 (GPIO24/SDIO_DAT0), S1.1
/Rasp Pi/RST: J3.4
/Rasp Pi/RX: J1.10 (GPIO15/UART_RXD), U21.3 (2-COM)
/Rasp Pi/RX0: J5.2, U21.1 (2Y0)
/Rasp Pi/RX1: J2.2, U21.5 (2Y1)
/Rasp Pi/TX: J1.8 (GPIO14/UART_TXD), U21.13 (1-COM)
/Rasp Pi/TX0: J5.3, U21.12 (1Y0)
/Rasp Pi/TX1: J2.3, U21.14 (1Y1)
GND: J1.6 (GND), J1.9 (GND), J1.14 (GND), J1.20 (GND), J1.25 (GND), J1.30 (GND), J1.34 (GND), J1.39 (GND), J2.4, J3.8, J5.4, S1.2, S1.C (COMMON), S1.SH1 (SHIELD), S1.SH2 (SHIELD__1), U21.6 (INH), U21.7 (GND), U21.8 (GND); also elsewhere on the board

Notes on the sheet:
RASPBERRY PI HEADER (FEMALE/SOCKET)
ROTARY ENCODER
OLED (ADAFRUIT 1.5")

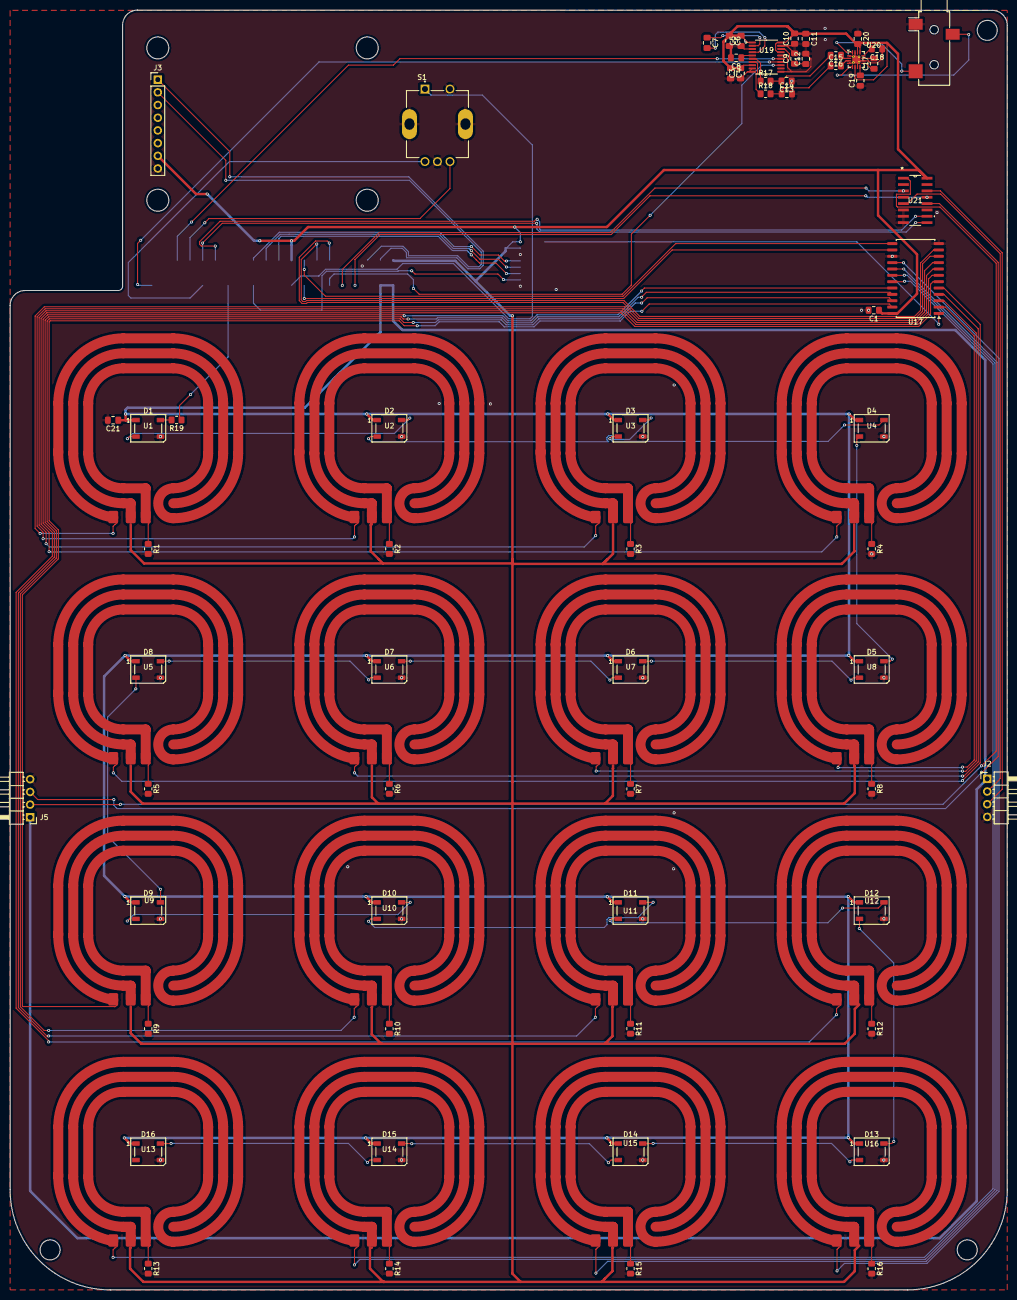
[picture p28: board final version.kicad_pcb from above]

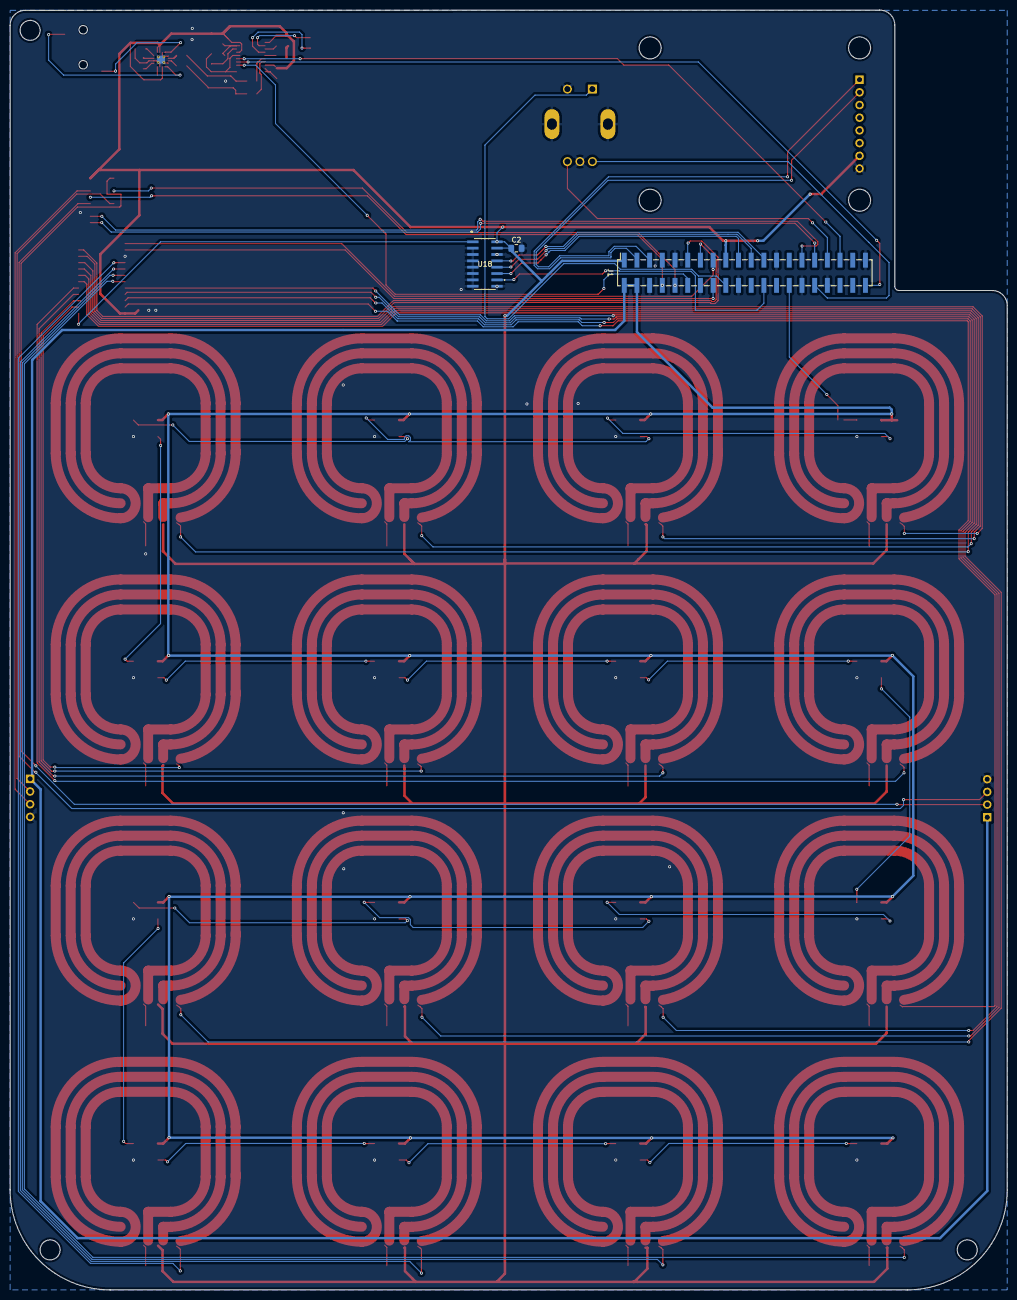
[picture p29: board final version.kicad_pcb from below]

Board: 2 copper layers, 199.5 x 256.1 mm, 83 parts (3 on the bottom side), 93 nets.
